IDontEatSoap/ExplorerElectronicsAndSoftware/Reference Media/PHOTO/20220421205409_000002.JPG

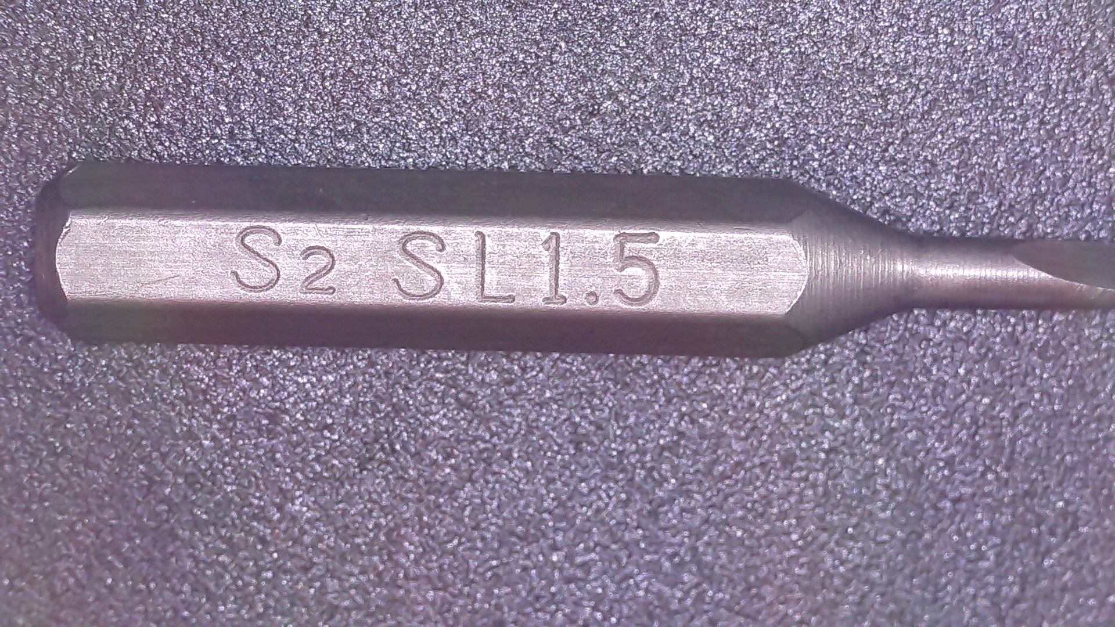
Reference Media/PHOTO/20220421205409_000002.JPG
