IDontEatSoap/ExplorerElectronicsAndSoftware/Reference Media/PHOTO/20250422212906_000017.JPG

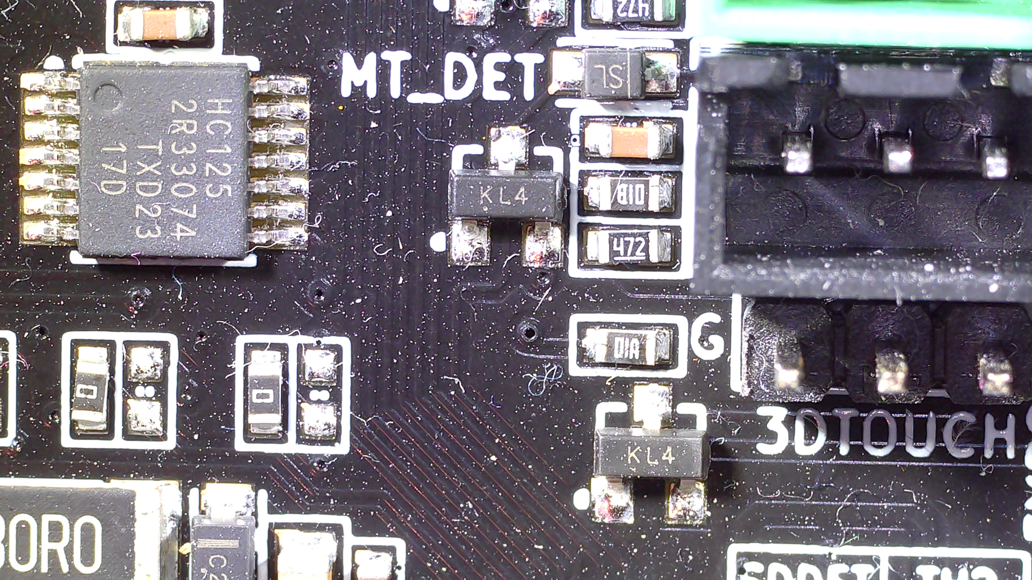
Reference Media/PHOTO/20250422212906_000017.JPG
