IDontEatSoap/ExplorerElectronicsAndSoftware/README.md

# ExplorerElectronicsAndSoftware
This is where I keep the Electronics and Software for my overlander motorhome
