IDontEatSoap/ExplorerElectronicsAndSoftware/Reference Media/PHOTO/20220421205602_000004.JPG

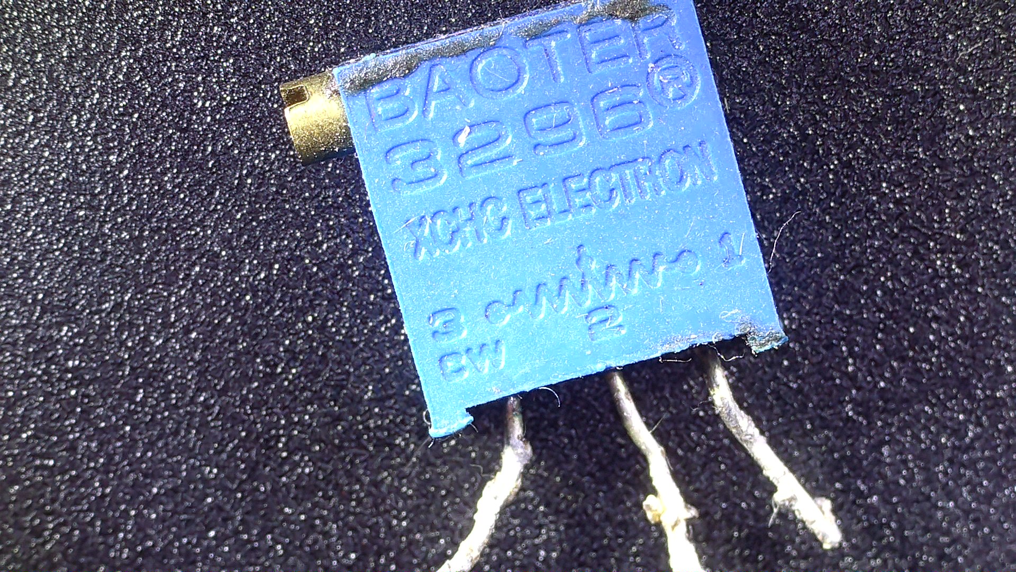
Reference Media/PHOTO/20220421205602_000004.JPG
