IDontEatSoap/ExplorerElectronicsAndSoftware/Reference Media/PHOTO/20250421210305_000007.JPG

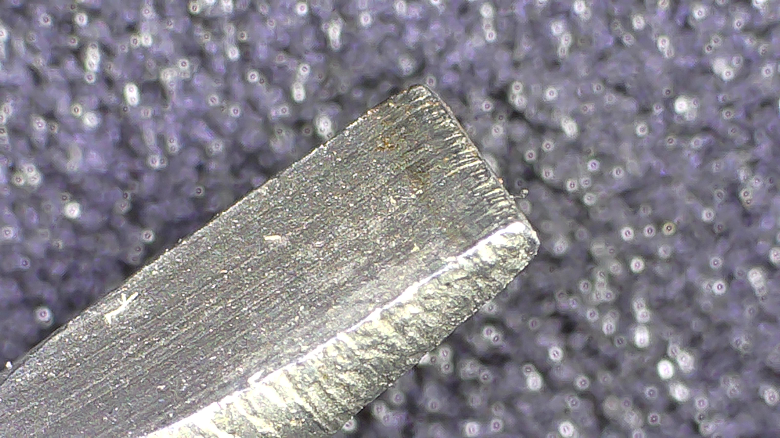
Reference Media/PHOTO/20250421210305_000007.JPG
