IDontEatSoap/ExplorerElectronicsAndSoftware/Reference Media/PHOTO/20250422212656_000009.JPG

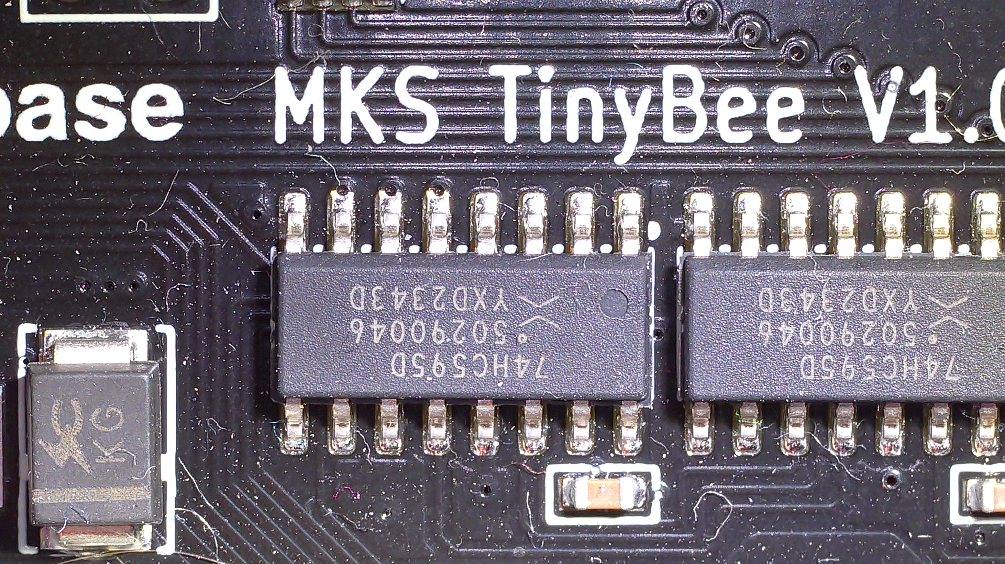
Reference Media/PHOTO/20250422212656_000009.JPG
