IDontEatSoap/ExplorerElectronicsAndSoftware/Reference Media/PHOTO/20250422212702_000010.JPG

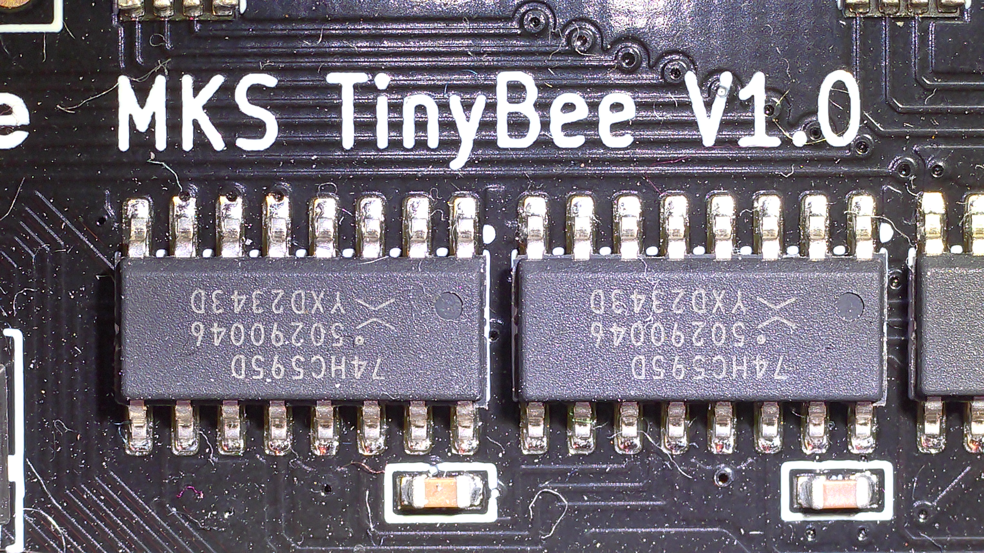
Reference Media/PHOTO/20250422212702_000010.JPG
