IDontEatSoap/ExplorerElectronicsAndSoftware/Reference Media/PHOTO/20250422212827_000014.JPG

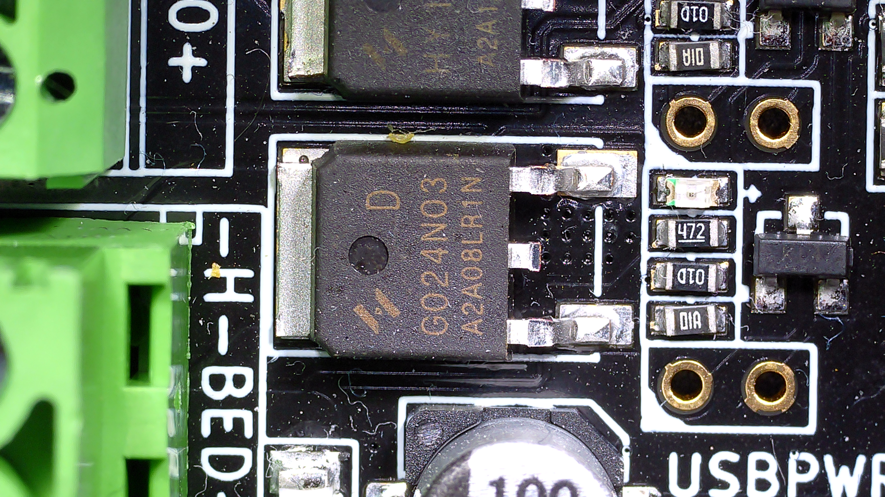
Reference Media/PHOTO/20250422212827_000014.JPG
