IDontEatSoap/ExplorerElectronicsAndSoftware/Reference Media/PHOTO/20250422212841_000015.JPG

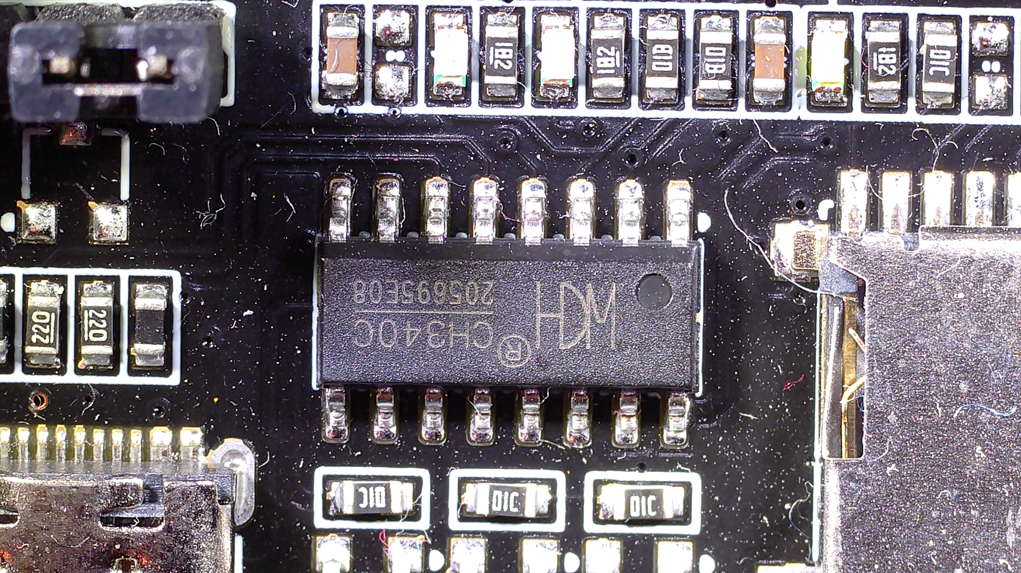
Reference Media/PHOTO/20250422212841_000015.JPG
