IDontEatSoap/ExplorerElectronicsAndSoftware/Reference Media/PHOTO/20250422212940_000018.JPG

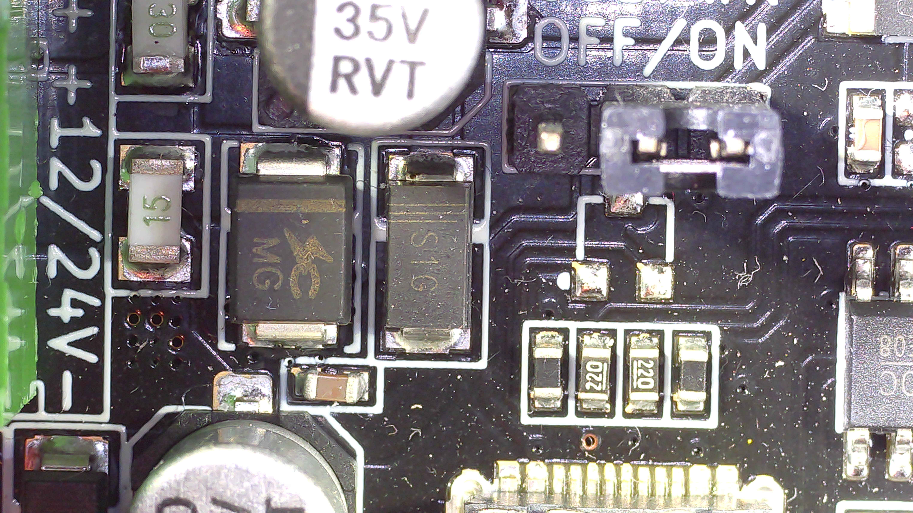
Reference Media/PHOTO/20250422212940_000018.JPG
