IDontEatSoap/ExplorerElectronicsAndSoftware/Reference Media/PHOTO/20250422213025_000019.JPG

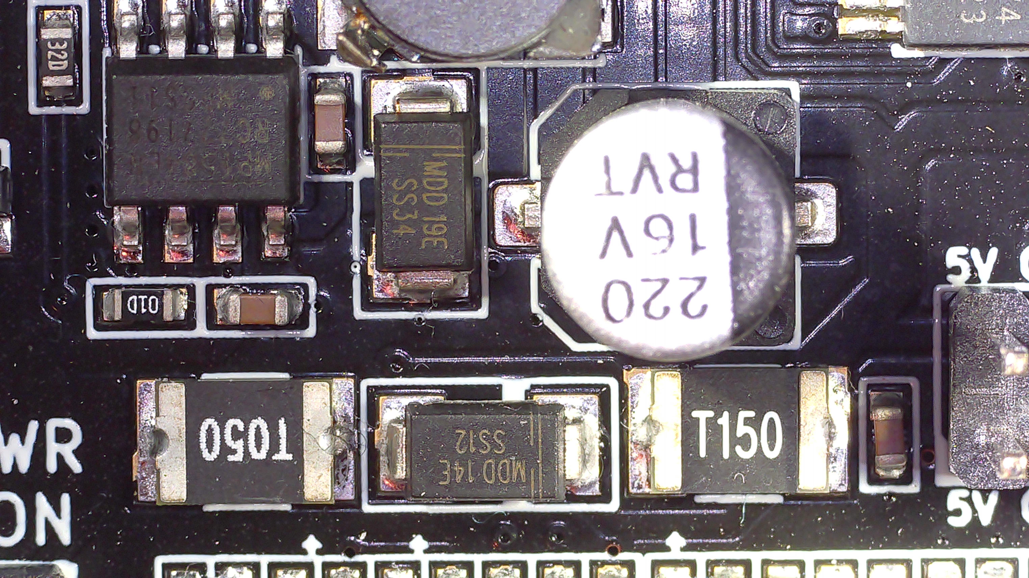
Reference Media/PHOTO/20250422213025_000019.JPG
