IDontEatSoap/ExplorerElectronicsAndSoftware/Reference Media/PHOTO/20250422213033_000020.JPG

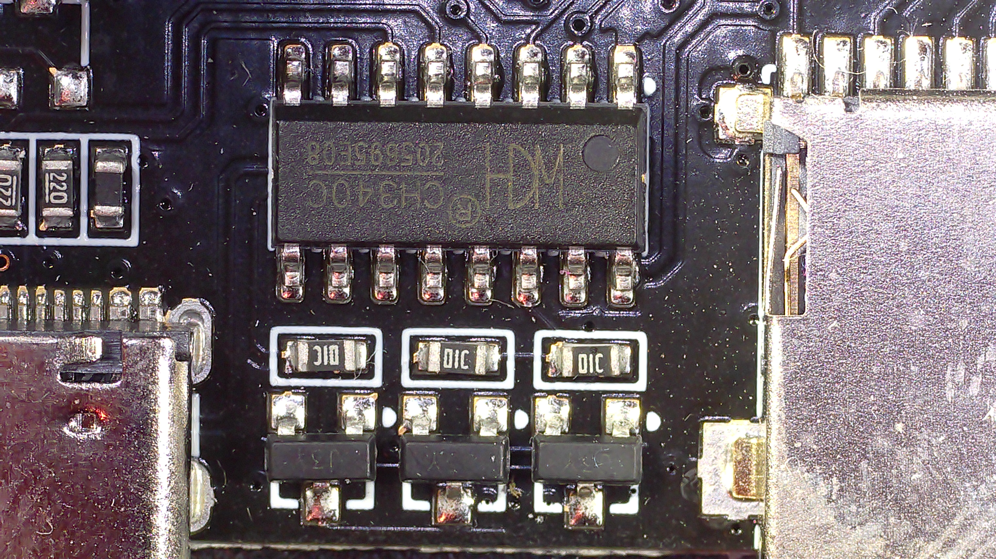
Reference Media/PHOTO/20250422213033_000020.JPG
