IDontEatSoap/ExplorerElectronicsAndSoftware/Reference Media/PHOTO/20250423002711_000021.JPG

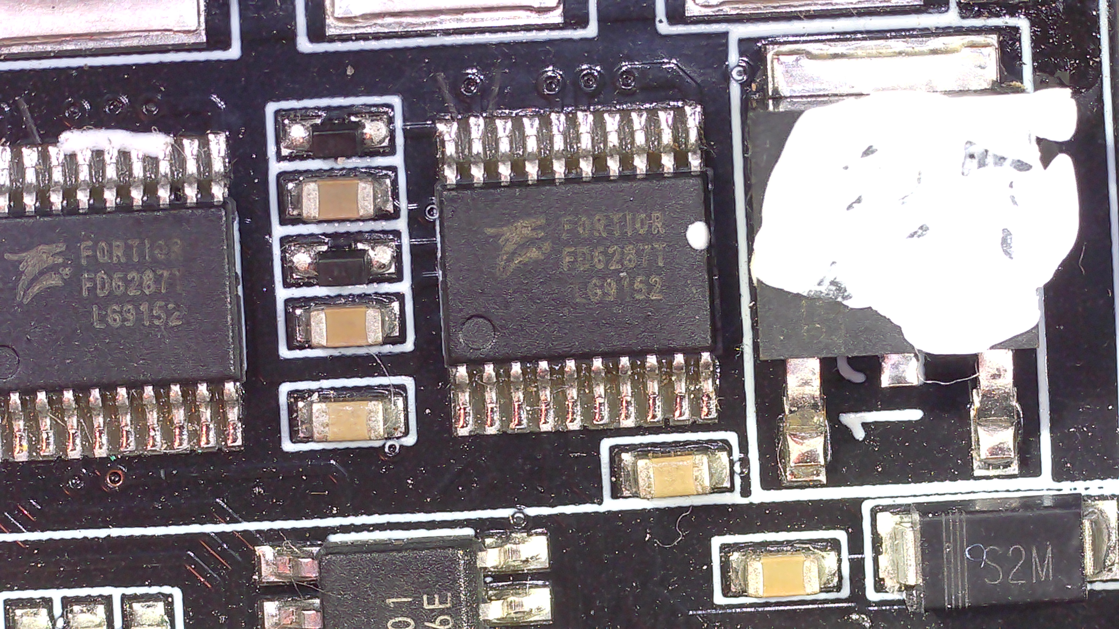
Reference Media/PHOTO/20250423002711_000021.JPG
