IDontEatSoap/ExplorerElectronicsAndSoftware/Reference Media/PHOTO/20250423002732_000023.JPG

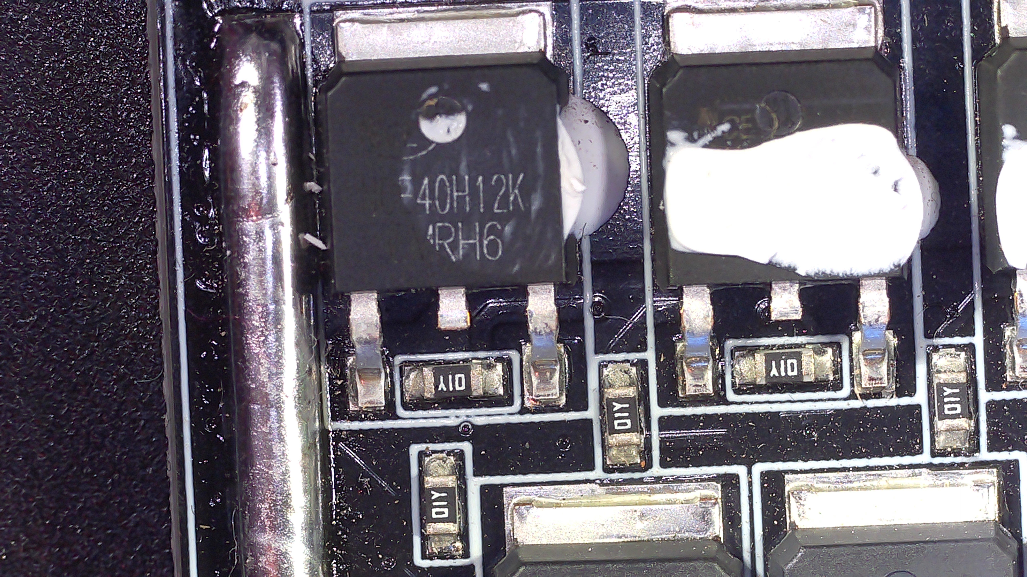
Reference Media/PHOTO/20250423002732_000023.JPG
