IDontEatSoap/ExplorerElectronicsAndSoftware/3mf/Esp32 Stepper Driver.step.3MF

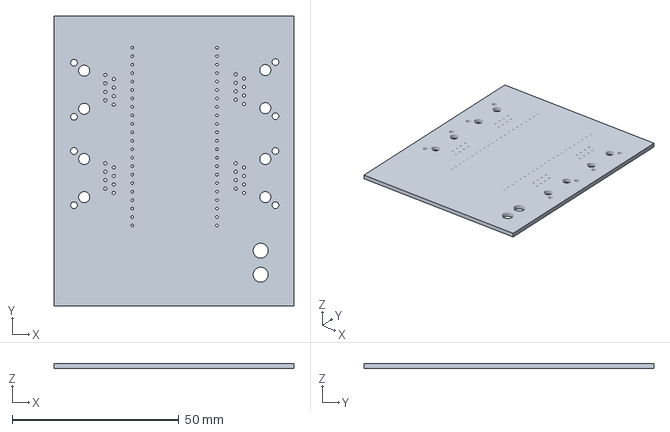
[picture p15: CAD file, 2025-02-13]
3mf/Esp32 Stepper Driver.step.3MF
72.0 x 87.0 x 1.60 mm
