IDontEatSoap/ExplorerElectronicsAndSoftware/ESP32 Bed Stepper Driver Adapter - r1/ESP32 Bed Stepper Driver Adapter.step

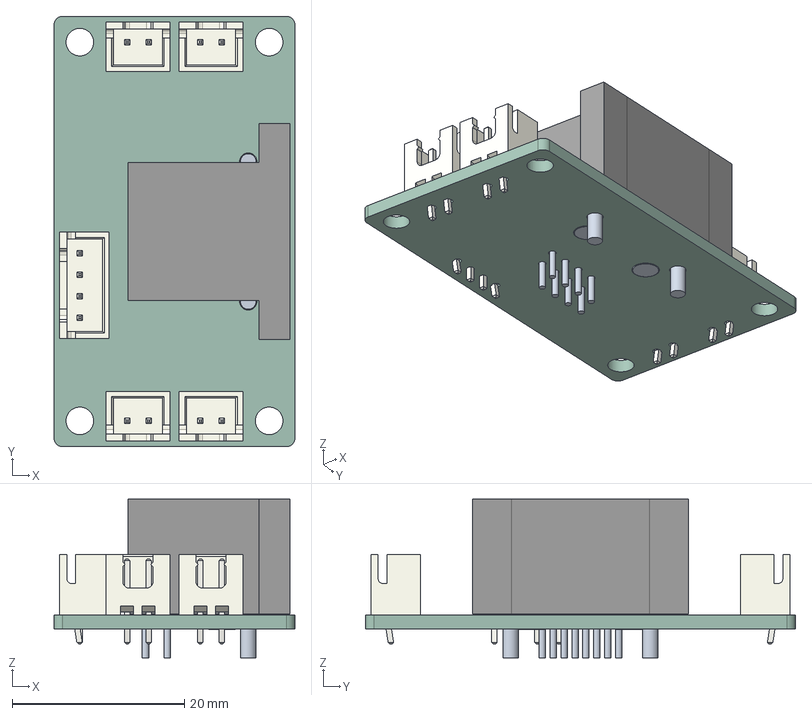
[picture p16: CAD file, 2025-02-13]
ESP32 Bed Stepper Driver Adapter - r1/ESP32 Bed Stepper Driver Adapter.step
28.0 x 50.0 x 18.4 mm
JST_B2B_XH_A x 4
ASSEMBLY
JST_B4B_XH_A
ESP32 Bed Stepper Driver Adapter_PCB
