IDontEatSoap/ExplorerElectronicsAndSoftware/ESP32 Bed Stepper Driver Controller - r1/Esp32 Stepper Driver.step

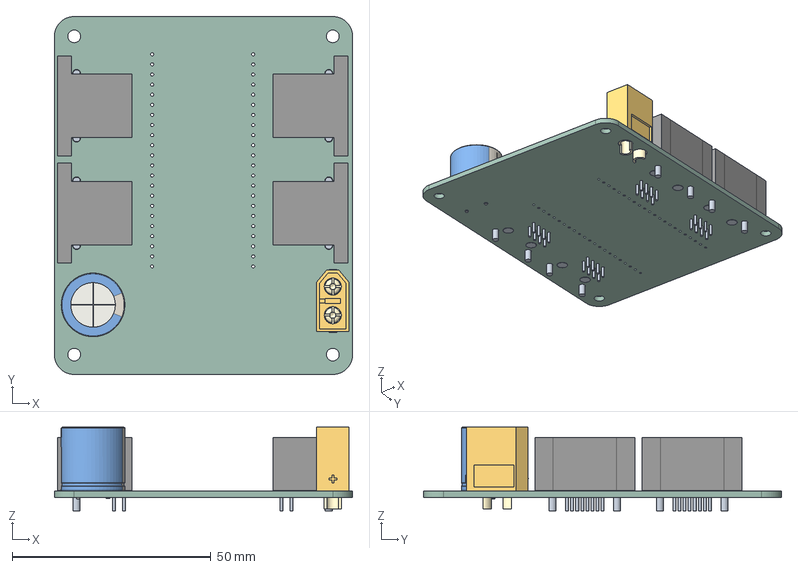
[picture p17: CAD file, 2025-02-13]
ESP32 Bed Stepper Driver Controller - r1/Esp32 Stepper Driver.step
75.0 x 90.0 x 21.0 mm
CP_Radial_D160mm_P750mm
XT60 male v9
ASSEMBLY x 4
Esp32 Stepper Driver_PCB
