IDontEatSoap/ExplorerElectronicsAndSoftware/3mf/Esp32 Stepper Driver.3MF

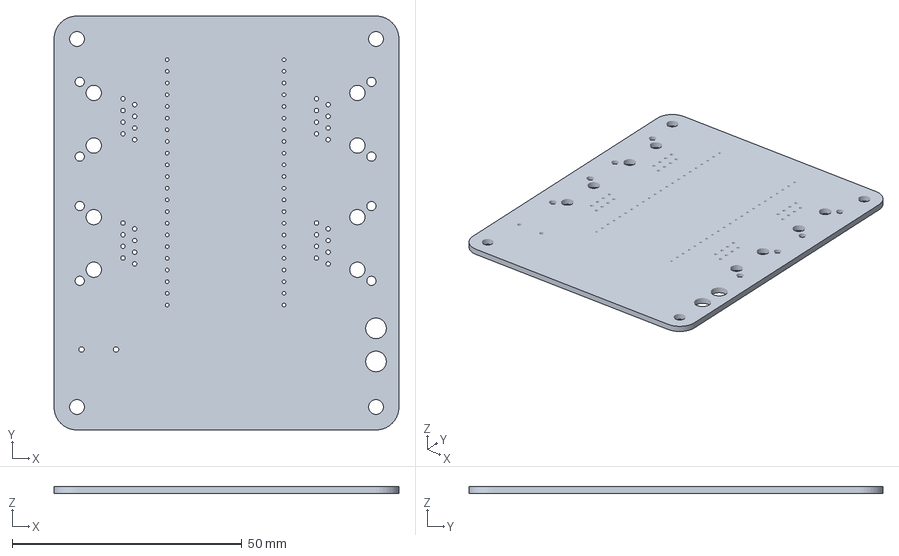
[picture p18: CAD file, 2025-02-13]
3mf/Esp32 Stepper Driver.3MF
75.0 x 90.0 x 1.60 mm
