IDontEatSoap/ExplorerElectronicsAndSoftware/3mf/ESP32 Bed Stepper Driver Adapter.step.3MF

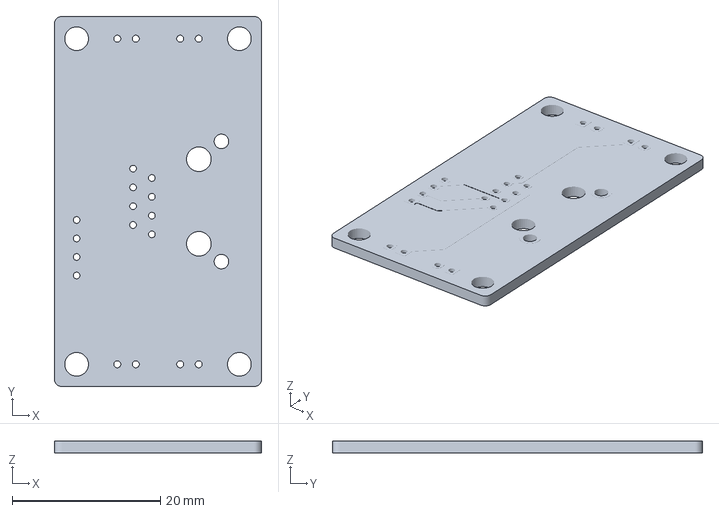
[picture p19: CAD file, 2025-02-13]
3mf/ESP32 Bed Stepper Driver Adapter.step.3MF
28.0 x 50.0 x 1.67 mm
