IDontEatSoap/ExplorerElectronicsAndSoftware/(list of files, cad)

Other CAD files:
3mf/ESP32 Bed Stepper Driver Adapter_pad_39.step.SLDPRT
ESP32 Bed Stepper Driver Controller - r1/Esp32 Stepper Driver.SLDASM
ESP32 Bed Stepper Driver Controller/Esp32 Stepper Driver.SLDASM
