IDontEatSoap/ExplorerElectronicsAndSoftware/ESP32 Bed Stepper Driver Adapter - r1/ESP32 Bed Stepper Driver Adapter.kicad_pcb

## KiCad design ESP32 Bed Stepper Driver Adapter - r1/ESP32 Bed Stepper Driver Adapter.kicad_pcb (2025-02-13)

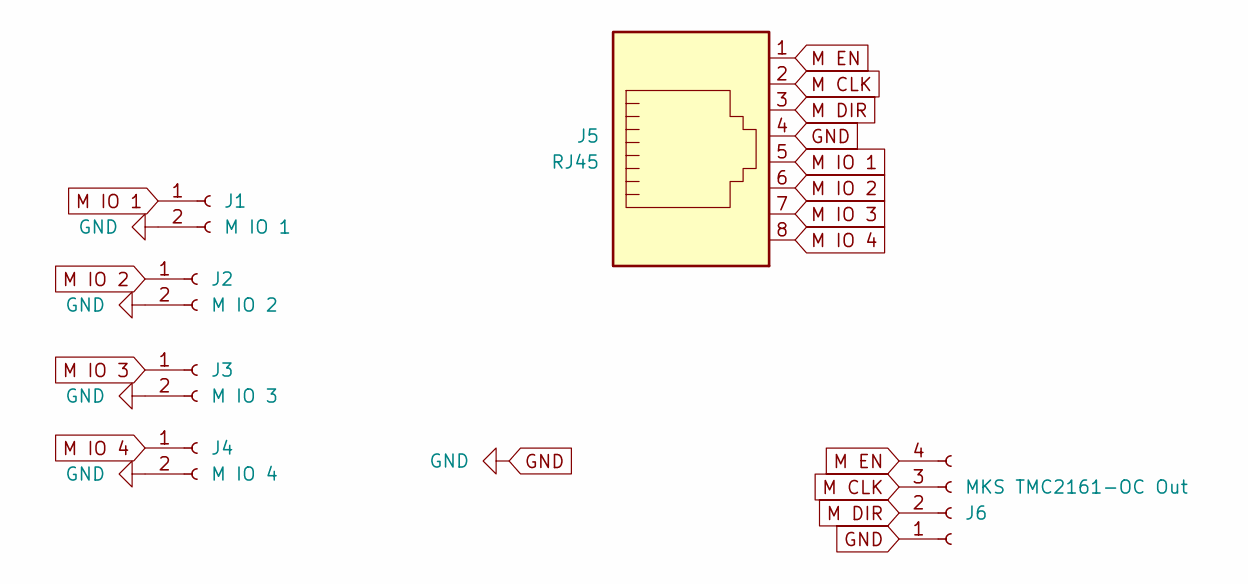
[picture p20: schematic ESP32 Bed Stepper Driver Adapter.kicad_sch]

Parts:
J1: M IO 1; JST_XH_B2B-XH-A_1x02_P2.50mm_Vertical
J2: M IO 2; JST_XH_B2B-XH-A_1x02_P2.50mm_Vertical
J3: M IO 3; JST_XH_B2B-XH-A_1x02_P2.50mm_Vertical
J4: M IO 4; JST_XH_B2B-XH-A_1x02_P2.50mm_Vertical
J5: RJ45; RJ458N3S
J6: MKS TMC2161-OC Out; JST_XH_B4B-XH-A_1x04_P2.50mm_Vertical

Connections:
GND: J1.2, J2.2, J3.2, J4.2, J5.4, J6.1
M CLK: J5.2, J6.3
M DIR: J5.3, J6.2
M EN: J5.1, J6.4
M IO 1: J1.1, J5.5
M IO 2: J2.1, J5.6
M IO 3: J3.1, J5.7
M IO 4: J4.1, J5.8

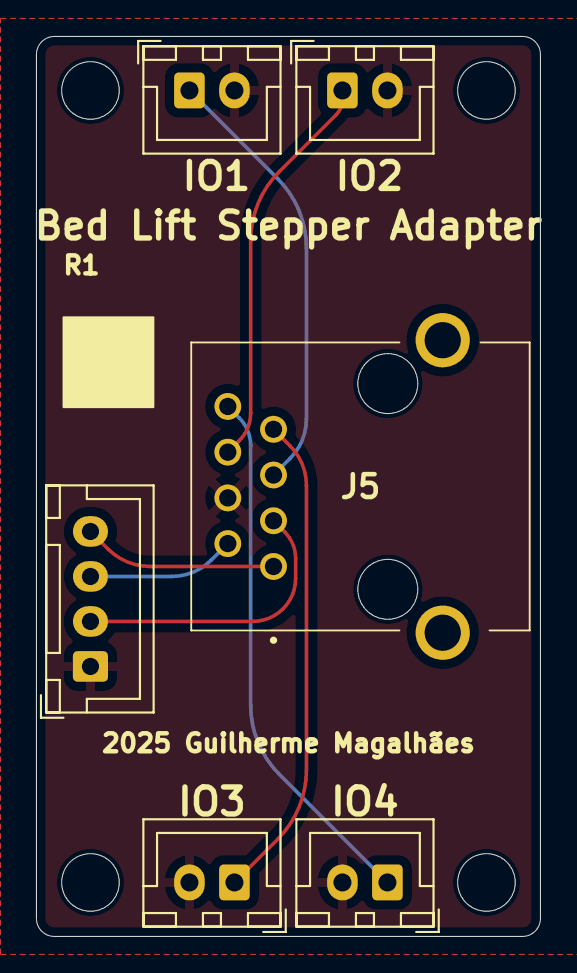
[picture p21: board ESP32 Bed Stepper Driver Adapter.kicad_pcb from above]

Board: 2 copper layers, 28.0 x 50.0 mm, 6 parts (0 on the bottom side), 8 nets.
