IDontEatSoap/ExplorerElectronicsAndSoftware/ESP32 Bed Stepper Driver Controller - r1/Esp32 Stepper Driver.kicad_pcb

## KiCad design ESP32 Bed Stepper Driver Controller - r1/Esp32 Stepper Driver.kicad_pcb (2025-02-13)

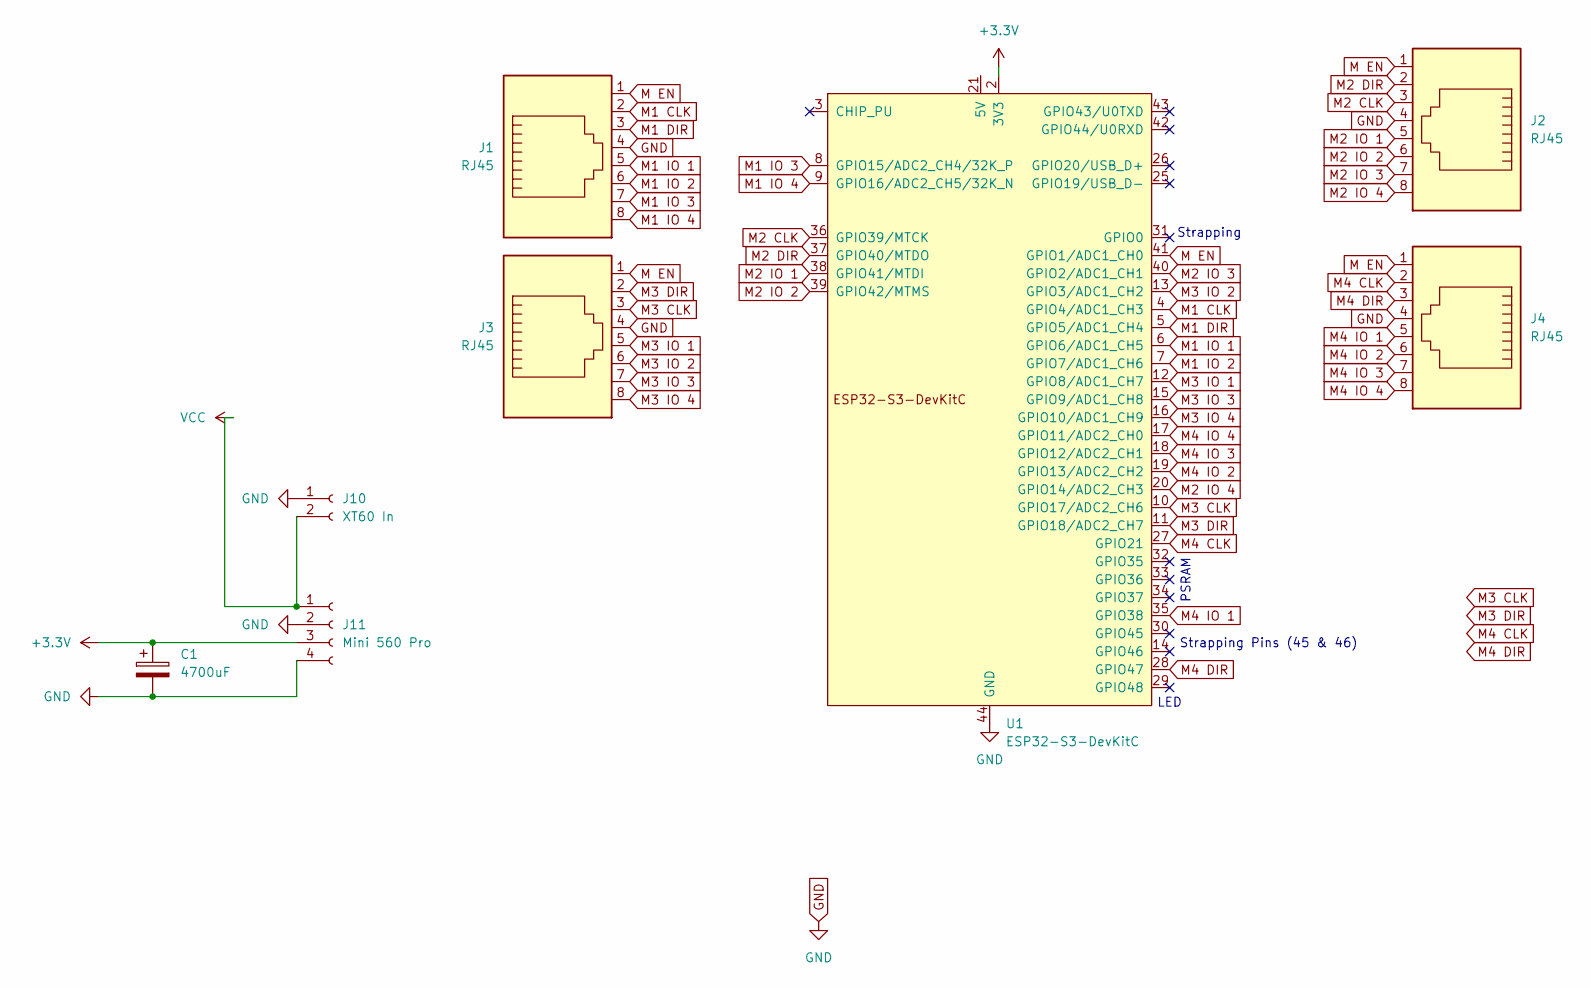
[picture p22: schematic Esp32 Stepper Driver.kicad_sch]

Parts:
C1: 4700uF; CP_Radial_D16.0mm_P7.50mm
J1, J2, J3, J4: RJ45; RJ458N3S
J10: XT60 In; AMASS_XT60PW-M_1x02_P7.20mm_Horizontal
J11: Mini 560 Pro
U1: ESP32-S3-DevKitC; ESP32-S3-DevKitC AliExpress

Connections:
+3.3V: C1.1, J11.3, U1.1 (3V3), U1.2 (3V3)
GND: C1.2, J1.4, J2.4, J3.4, J4.4, J10.1, J11.2, J11.4, U1.22 (GND), U1.23 (GND), U1.24 (GND), U1.44 (GND)
M1 CLK: J1.2, U1.4 (GPIO4/ADC1_CH3)
M1 DIR: J1.3, U1.5 (GPIO5/ADC1_CH4)
M1 IO 1: J1.5, U1.6 (GPIO6/ADC1_CH5)
M1 IO 2: J1.6, U1.7 (GPIO7/ADC1_CH6)
M1 IO 3: J1.7, U1.8 (GPIO15/ADC2_CH4/32K_P)
M1 IO 4: J1.8, U1.9 (GPIO16/ADC2_CH5/32K_N)
M2 CLK: J2.3, U1.36 (GPIO39/MTCK)
M2 DIR: J2.2, U1.37 (GPIO40/MTDO)
M2 IO 1: J2.5, U1.38 (GPIO41/MTDI)
M2 IO 2: J2.6, U1.39 (GPIO42/MTMS)
M2 IO 3: J2.7, U1.40 (GPIO2/ADC1_CH1)
M2 IO 4: J2.8, U1.20 (GPIO14/ADC2_CH3)
M3 CLK: J3.3, U1.10 (GPIO17/ADC2_CH6)
M3 DIR: J3.2, U1.11 (GPIO18/ADC2_CH7)
M3 IO 1: J3.5, U1.12 (GPIO8/ADC1_CH7)
M3 IO 2: J3.6, U1.13 (GPIO3/ADC1_CH2)
M3 IO 3: J3.7, U1.15 (GPIO9/ADC1_CH8)
M3 IO 4: J3.8, U1.16 (GPIO10/ADC1_CH9)
M4 CLK: J4.2, U1.27 (GPIO21)
M4 DIR: J4.3, U1.28 (GPIO47)
M4 IO 1: J4.5, U1.35 (GPIO38)
M4 IO 2: J4.6, U1.19 (GPIO13/ADC2_CH2)
M4 IO 3: J4.7, U1.18 (GPIO12/ADC2_CH1)
M4 IO 4: J4.8, U1.17 (GPIO11/ADC2_CH0)
M EN: J1.1, J2.1, J3.1, J4.1, U1.41 (GPIO1/ADC1_CH0)
VCC: J10.2, J11.1

Notes on the sheet:
LED
Strapping Pins (45 & 46)
PSRAM
Strapping

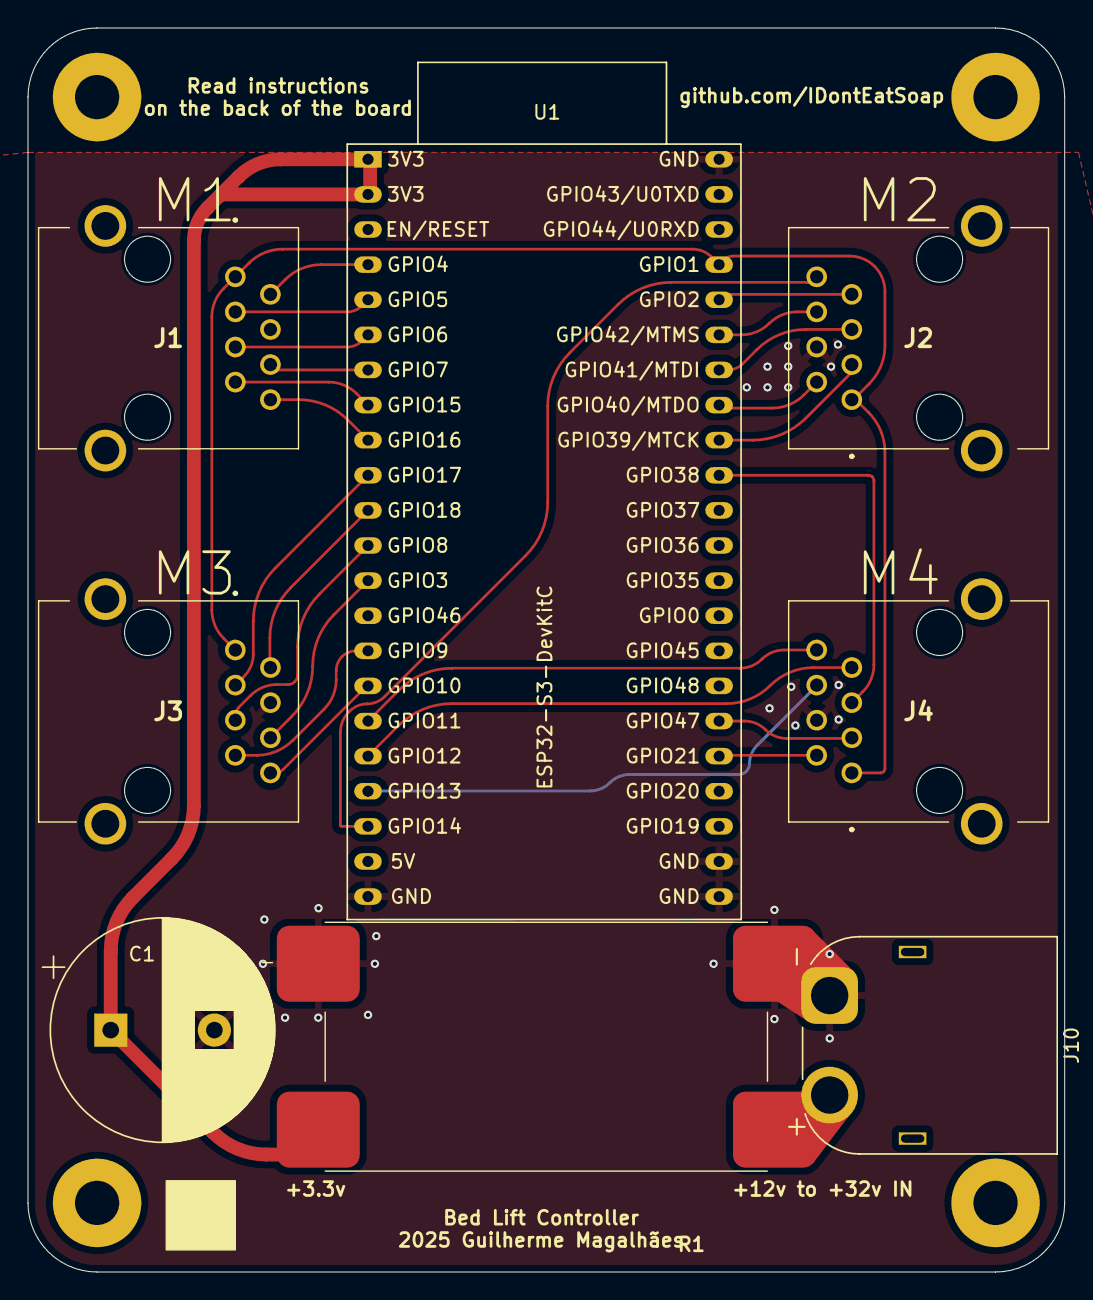
[picture p23: board Esp32 Stepper Driver.kicad_pcb from above]

Board: 2 copper layers, 75.0 x 90.0 mm, 8 parts (0 on the bottom side), 28 nets.
