IDontEatSoap/ExplorerElectronicsAndSoftware/ESP32 Door Controller/Door Controller.kicad_pcb

## KiCad design ESP32 Door Controller/Door Controller.kicad_pcb (2025-02-13)

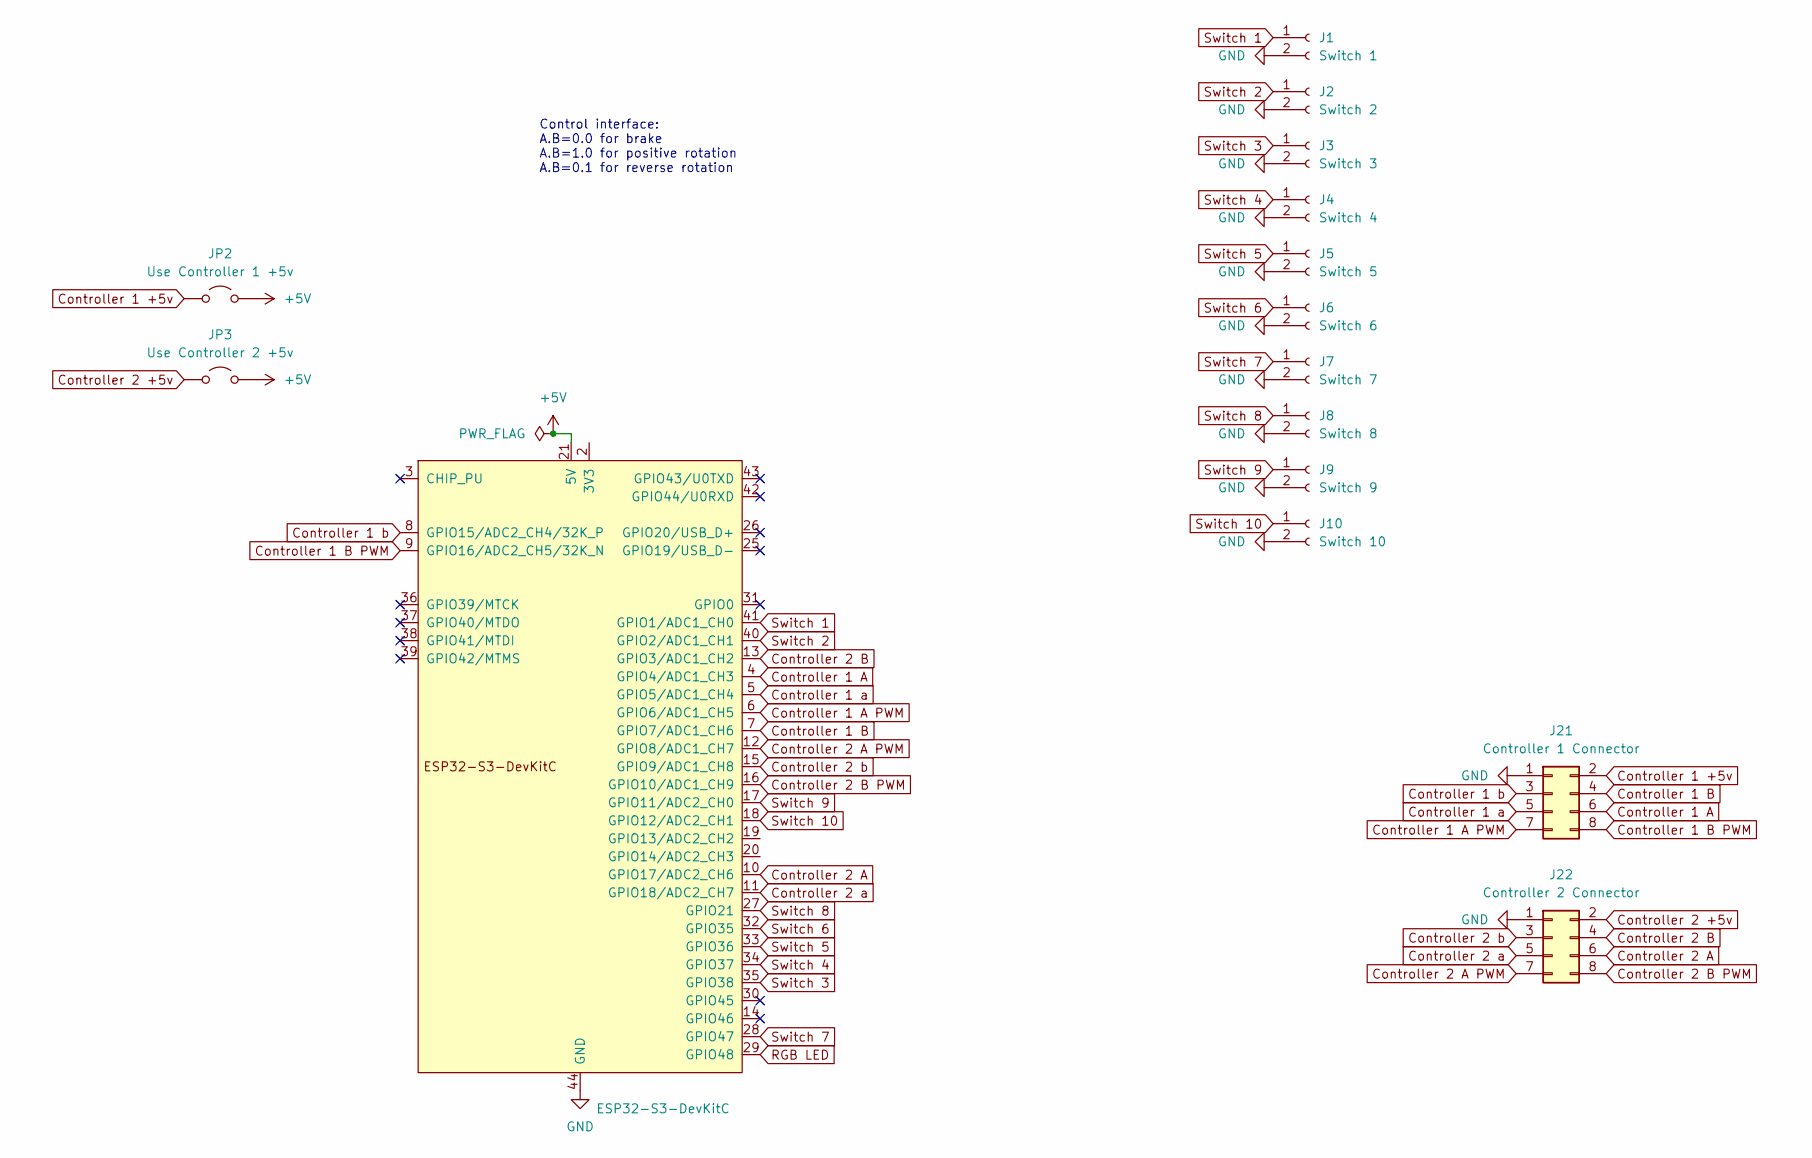
[picture p24: schematic Door Controller.kicad_sch]

Parts:
J1: Switch 1; JST_XH_B2B-XH-A_1x02_P2.50mm_Vertical
J2: Switch 2; JST_XH_B2B-XH-A_1x02_P2.50mm_Vertical
J3: Switch 3; JST_XH_B2B-XH-A_1x02_P2.50mm_Vertical
J4: Switch 4; JST_XH_B2B-XH-A_1x02_P2.50mm_Vertical
J5: Switch 5; JST_XH_B2B-XH-A_1x02_P2.50mm_Vertical
J6: Switch 6; JST_XH_B2B-XH-A_1x02_P2.50mm_Vertical
J7: Switch 7; JST_XH_B2B-XH-A_1x02_P2.50mm_Vertical
J8: Switch 8; JST_XH_B2B-XH-A_1x02_P2.50mm_Vertical
J9: Switch 9; JST_XH_B2B-XH-A_1x02_P2.50mm_Vertical
J10: Switch 10; JST_XH_B2B-XH-A_1x02_P2.50mm_Vertical
J21: Controller 1 Connector; IDC-Header_2x04_P2.54mm_Vertical
J22: Controller 2 Connector; IDC-Header_2x04_P2.54mm_Vertical
JP2: Use Controller 1 +5v; SolderJumper-2_P1.3mm_Open_RoundedPad1.0x1.5mm
JP3: Use Controller 2 +5v; SolderJumper-2_P1.3mm_Open_RoundedPad1.0x1.5mm
U1: ESP32-S3-DevKitC; ESP32-S3-DevKitC AliExpress

Connections:
+5V: JP2.2 (B), JP3.2 (B), U1.21 (5V)
Controller 1 +5v: J21.2, JP2.1 (A)
Controller 1 A: J21.6, U1.4 (GPIO4/ADC1_CH3)
Controller 1 A PWM: J21.7, U1.6 (GPIO6/ADC1_CH5)
Controller 1 B: J21.4, U1.7 (GPIO7/ADC1_CH6)
Controller 1 B PWM: J21.8, U1.9 (GPIO16/ADC2_CH5/32K_N)
Controller 1 a: J21.5, U1.5 (GPIO5/ADC1_CH4)
Controller 1 b: J21.3, U1.8 (GPIO15/ADC2_CH4/32K_P)
Controller 2 +5v: J22.2, JP3.1 (A)
Controller 2 A: J22.6, U1.10 (GPIO17/ADC2_CH6)
Controller 2 A PWM: J22.7, U1.12 (GPIO8/ADC1_CH7)
Controller 2 B: J22.4, U1.13 (GPIO3/ADC1_CH2)
Controller 2 B PWM: J22.8, U1.16 (GPIO10/ADC1_CH9)
Controller 2 a: J22.5, U1.11 (GPIO18/ADC2_CH7)
Controller 2 b: J22.3, U1.15 (GPIO9/ADC1_CH8)
GND: J1.2, J2.2, J3.2, J4.2, J5.2, J6.2, J7.2, J8.2, J9.2, J10.2, J21.1, J22.1, U1.22 (GND), U1.23 (GND), U1.24 (GND), U1.44 (GND)
unnamed: U1.1 (3V3), U1.2 (3V3)
RGB LED: U1.29 (GPIO48)
Switch 1: J1.1, U1.41 (GPIO1/ADC1_CH0)
Switch 2: J2.1, U1.40 (GPIO2/ADC1_CH1)
Switch 3: J3.1, U1.35 (GPIO38)
Switch 4: J4.1, U1.34 (GPIO37)
Switch 5: J5.1, U1.33 (GPIO36)
Switch 6: J6.1, U1.32 (GPIO35)
Switch 7: J7.1, U1.28 (GPIO47)
Switch 8: J8.1, U1.27 (GPIO21)
Switch 9: J9.1, U1.17 (GPIO11/ADC2_CH0)
Switch 10: J10.1, U1.18 (GPIO12/ADC2_CH1)

Notes on the sheet:
Control interface: A.B=0.0 for brake A.B=1.0 for positive rotation A.B=0.1 for reverse rotation

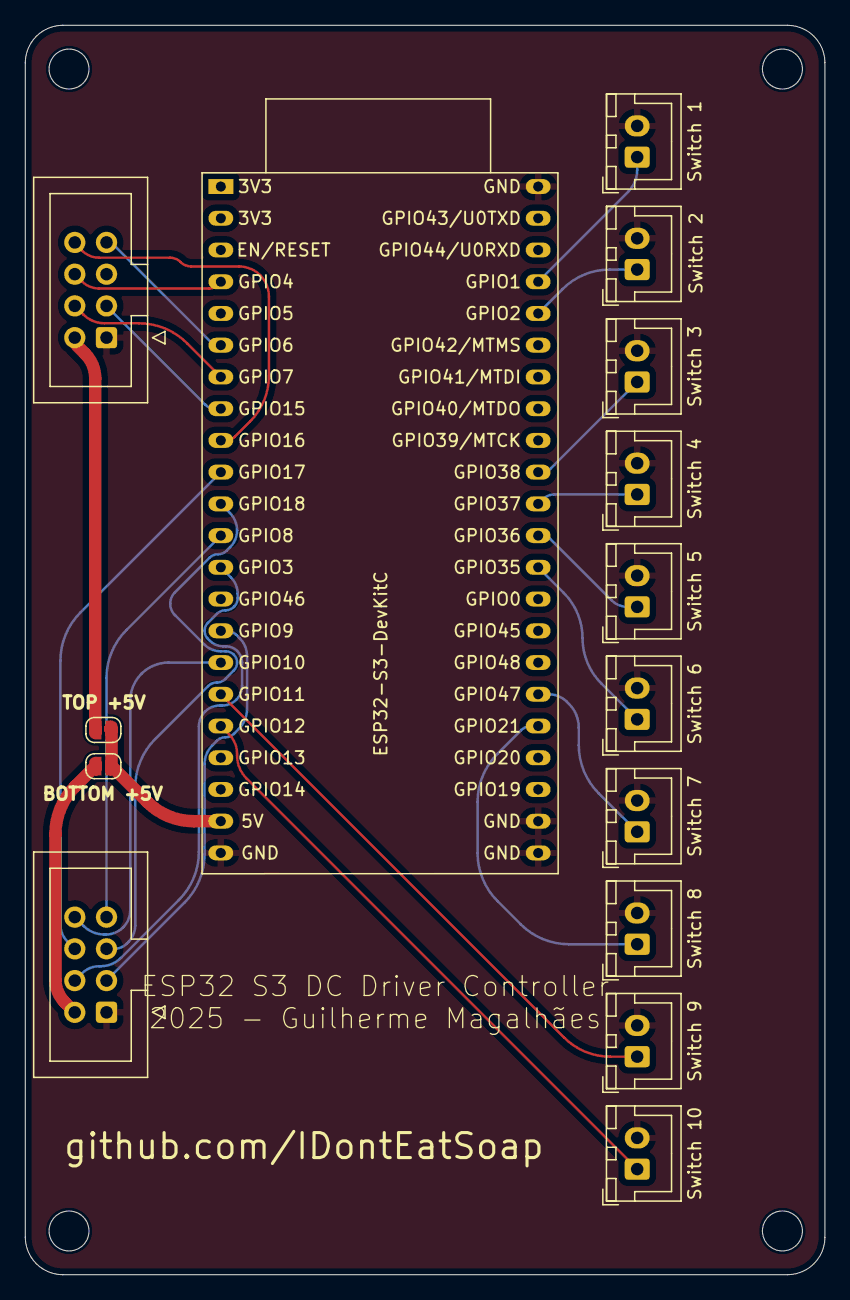
[picture p25: board Door Controller.kicad_pcb from above]

Board: 2 copper layers, 64.0 x 100.0 mm, 19 parts (0 on the bottom side), 27 nets.

Other parts of the board:
h1, h2, h3, h4: MountingHole_3.2mm_M3
