IDontEatSoap/ExplorerElectronicsAndSoftware/ESP32 DC Driver/ESP32 DC Driver.kicad_pcb

## KiCad design ESP32 DC Driver/ESP32 DC Driver.kicad_pcb (2025-02-13)

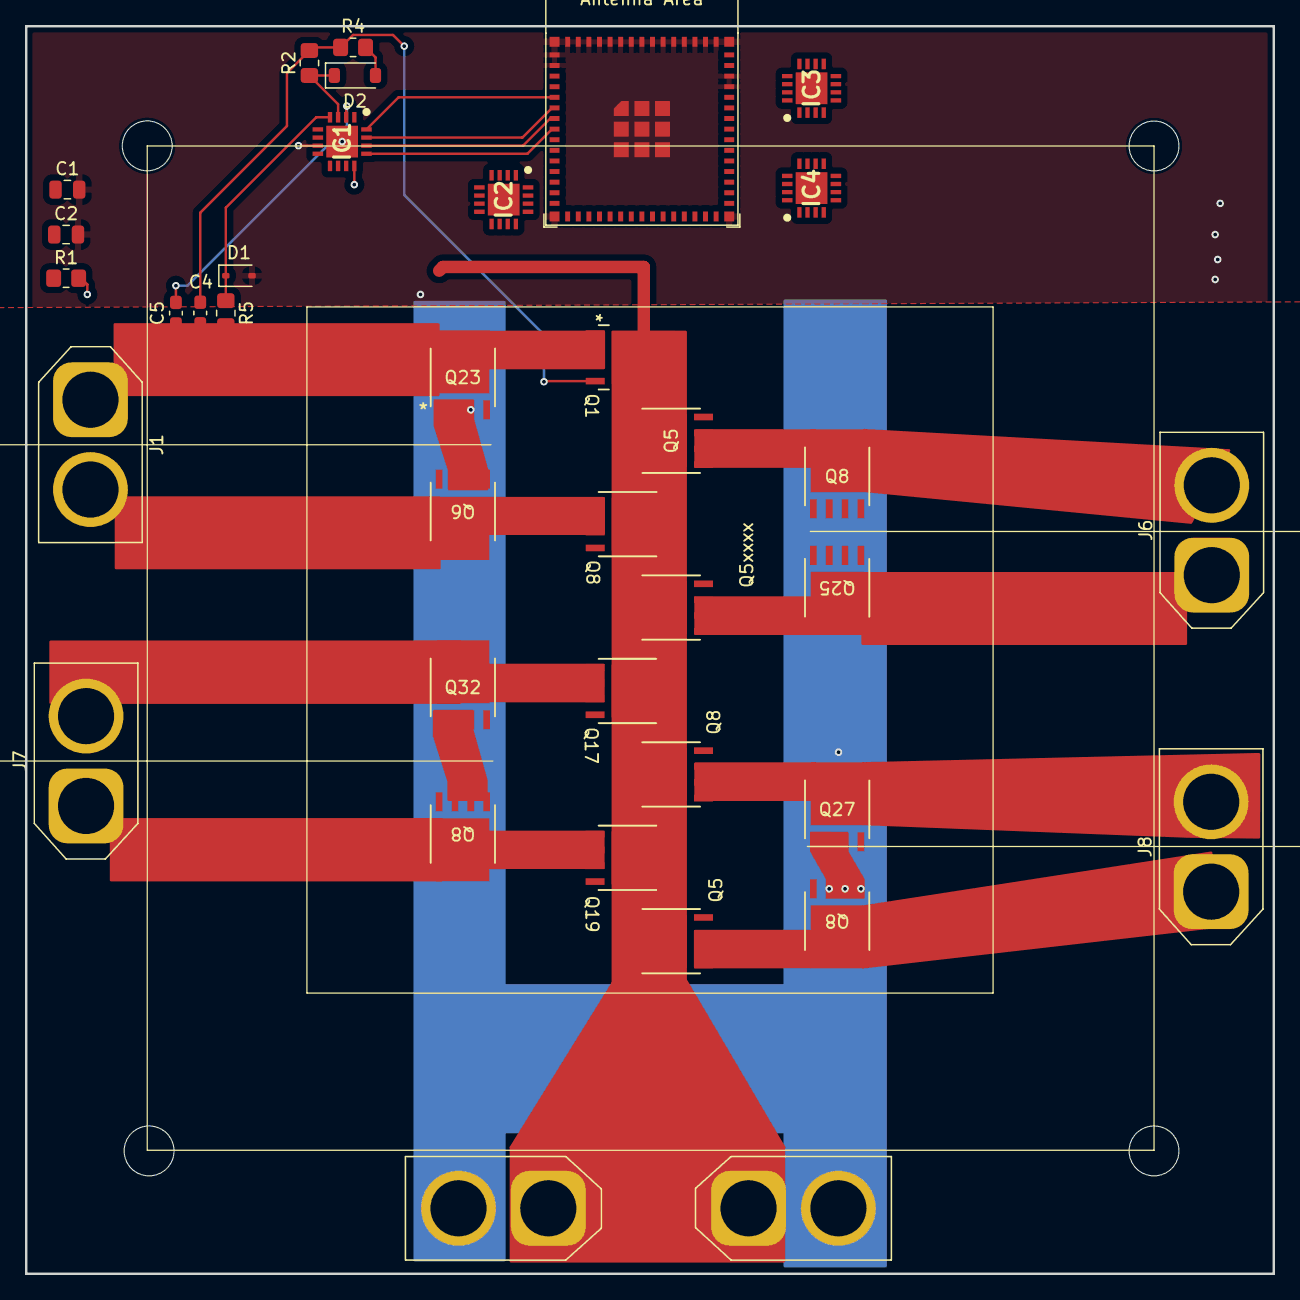
[picture p26: board ESP32 DC Driver.kicad_pcb from above]

Board: 4 copper layers, 100.0 x 100.0 mm, 37 parts (0 on the bottom side), 35 nets.

Parts:
C1: 10uf; C_0805_2012Metric
C2: 1uf; C_0805_2012Metric
C4: 4700pF; C_0603_1608Metric_Pad1.08x0.95mm_HandSolder
C5: 10uf; C_0603_1608Metric_Pad1.08x0.95mm_HandSolder
D1: BAS316; D_SOD-323
D2: 1N4148; D_SOD-123
IC1, IC2, IC3, IC4: MIC4606-1YML-TR; QFN65P400X400X90-17N-D
J1: AMASS_XT60-M_1x02_P7.20mm_Vertical
J6, J7, J8: Output 1; AMASS_XT60-M_1x02_P7.20mm_Vertical
Q1, Q5, Q5#2, Q5xxxx, Q6, Q8, Q8#2, Q8#3, Q8#4, Q8#5, Q17, Q19, Q23, Q25, Q27, Q32: SQJ182EP-T1_GE3; PowerPAK_SO-8L_PPKSO8LWLA_Case_Outline_3_VIS
R1: 100k; R_0805_2012Metric_Pad1.20x1.40mm_HandSolder
R2: 18R; R_0805_2012Metric_Pad1.20x1.40mm_HandSolder
R4: 6.8R; R_0805_2012Metric_Pad1.20x1.40mm_HandSolder
R5: 3.3R; R_0805_2012Metric_Pad1.20x1.40mm_HandSolder
U2: ESP32-S3-MINI-1
xxx: AMASS_XT60-M_1x02_P7.20mm_Vertical
xxx#2: AMASS_XT60-M_1x02_P7.20mm_Vertical

Connections:
/AH1/G: C4.1, Q1.4, Q19.4, R2.2, R4.2
/AH1/S: C4.2, C5.2, J1.1, Q1.1, Q1.2, Q1.3, Q19.1, Q19.2, Q19.3, R5.2
/AH2/S: J6.2, Q5.1, Q5.2, Q5.3, Q8#2.5, Q23.5
/AH4/S: J8.2, Q8#4.1, Q8#4.2, Q8#4.3, Q27.5
/AL2/G: Q8#2.4, Q23.4
/BH1/G: Q8#3.4, Q17.4
/BH1/S: J1.2, Q6.5, Q8#3.1, Q8#3.2, Q8#3.3, Q17.1, Q17.2, Q17.3, Q32.5
/BH2/S: J6.1, Q5xxxx.1, Q5xxxx.2, Q5xxxx.3, Q25.5
/BH3/S: J7.1, Q8#5.5
/BH4/S: J8.1, Q5#2.1, Q5#2.2, Q5#2.3, Q8.5
/BL1/G: Q6.4, Q32.4
GND: C1.2, C2.2, D1.2 (A), IC1.7 (VSS), IC1.17 (GND), IC2.7 (VSS), IC2.17 (GND), IC3.7 (VSS), IC3.17 (GND), IC4.7 (VSS), IC4.17 (GND), Q6.1, Q6.2, Q6.3, Q8.1, Q8.2, Q8.3, Q8#2.1, Q8#2.2, Q8#2.3, Q8#5.1, Q8#5.2, Q8#5.3, Q23.1, Q23.2, Q23.3, Q25.1, Q25.2, Q25.3, Q27.1, Q27.2, Q27.3, Q32.1, Q32.2, Q32.3, U2.1 (GND), U2.2 (GND), U2.42 (GND), U2.43 (GND), U2.46 (GND), U2.47 (GND), U2.48 (GND), U2.49 (GND), U2.50 (GND), U2.51 (GND), U2.52 (GND), U2.53 (GND), U2.54 (GND), U2.55 (GND), U2.56 (GND), U2.57 (GND), U2.58 (GND), U2.59 (GND), U2.60 (GND), U2.61 (GND), U2.62 (GND), U2.63 (GND), U2.64 (GND), U2.65 (GND), xxx.2, xxx#2.2
Motor 1 AHI: IC1.16 (AHI), U2.5 (GPIO1/TOUCH1/ADC1_CH0)
Motor 1 ALI: IC1.15 (ALI), U2.6 (GPIO2/TOUCH2/ADC1_CH1)
Motor 1 BHI: IC1.13 (BHI), U2.8 (GPIO4/TOUCH4/ADC1_CH3)
Motor 1 BLI: IC1.14 (BLI), U2.7 (GPIO3/TOUCH3/ADC1_CH2)
Motor 2 AHI: IC2.16 (AHI), U2.9 (GPIO5/TOUCH5/ADC1_CH4)
Motor 2 ALI: IC2.15 (ALI), U2.10 (GPIO6/TOUCH6/ADC1_CH5)
Motor 2 BHI: IC2.13 (BHI), U2.12 (GPIO8/TOUCH8/ADC1_CH7/SUBSPICS1)
Motor 2 BLI: IC2.14 (BLI), U2.11 (GPIO7/TOUCH7/ADC1_CH6)
Motor 3 AHI: IC3.16 (AHI), U2.13 (GPIO9/TOUCH9/ADC1_CH8/FSPIHD/SUBSPIHD)
Motor 3 ALI: IC3.15 (ALI), U2.14 (GPIO10/TOUCH10/ADC1_CH9/FSPICS0/FSPIIO4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)
Motor 3 BHI: IC3.13 (BHI), U2.16 (GPIO12/TOUCH12/ADC2_CH1/FSPICLK/FSPIIO6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)
Motor 3 BLI: IC3.14 (BLI), U2.15 (GPIO11/TOUCH11/ADC2_CH0/FSPID/FSPIIO5/S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)
Motor 4 AHI: IC4.16 (AHI), U2.17 (GPIO13/TOUCH13/ADC2_CH2/FSPIQ/FSPIIO7/S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)
Motor 4 ALI: IC4.15 (ALI), U2.18 (GPIO14/TOUCH14/ADC2_CH3/FSPIWP/FSPIDQS/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)
Motor 4 BHI: IC4.13 (BHI), U2.22 (GPIO18/U1RXD/ADC2_CH7/CLK_OUT3)
Motor 4 BLI: IC4.14 (BLI), U2.21 (GPIO17/U1TXD/ADC2_CH6)
unnamed: D1.1 (K), IC1.4 (AHS), R5.1
unnamed: D2.2 (A), R4.1
unnamed: D2.1 (K), IC1.3 (AHO), R2.1
unnamed: C5.1, IC1.2 (AHB)
unnamed: IC1.12 (EN), R1.2
VBUS: Q1.5, Q5.5, Q5#2.5, Q5xxxx.5, Q8#3.5, Q8#4.5, Q17.5, Q19.5
VDD: C1.1, C2.1, IC1.6 (VDD), IC2.6 (VDD), IC3.6 (VDD), IC4.6 (VDD), R1.1
