IDontEatSoap/ExplorerElectronicsAndSoftware/Reference Media/PHOTO/20250422212729_000012.JPG

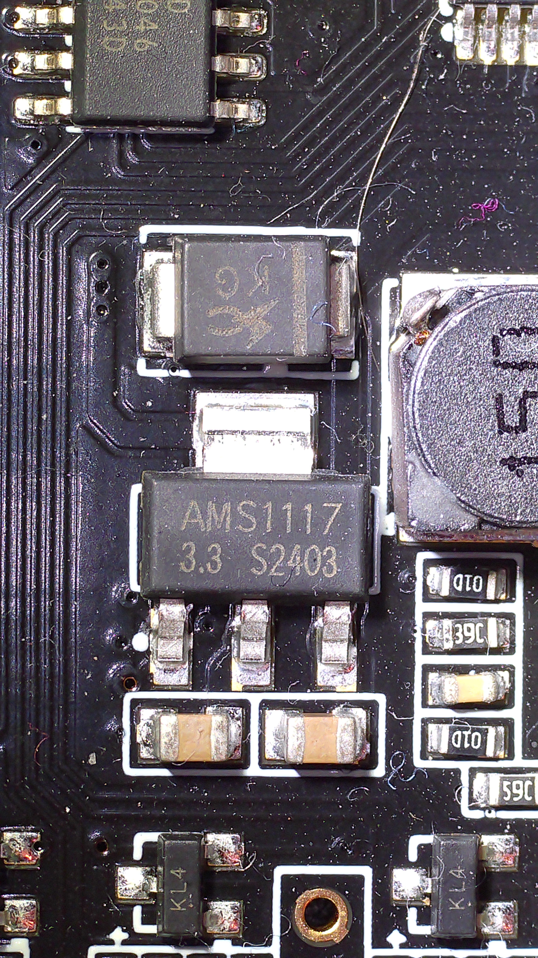
Reference Media/PHOTO/20250422212729_000012.JPG
